emaneric/LED-heart-wearable/PCB/graphics-and-outline/main-PCB-Edge_Cuts.dxf

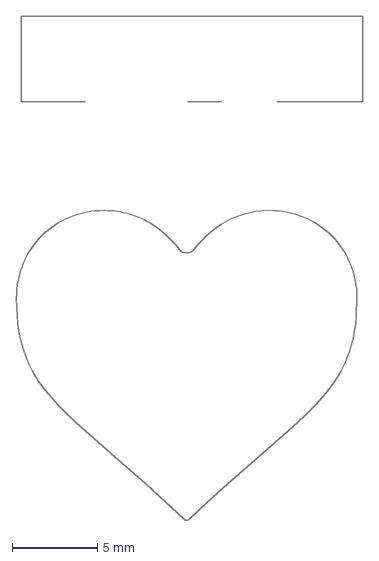
[picture p1: CAD file, 2026-05-04]
PCB/graphics-and-outline/main-PCB-Edge_Cuts.dxf
20.3 x 29.5 mm
