emaneric/LED-heart-wearable/PCB/aux-PCB/aux-PCB.step

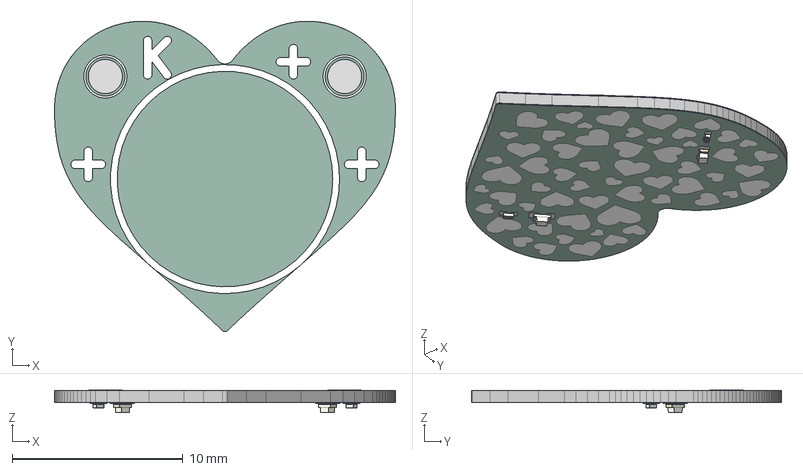
[picture p2: CAD file, 2026-03-15]
PCB/aux-PCB/aux-PCB.step
19.9 x 18.2 x 1.37 mm
R_0201_0603Metric x 2
LED_0402_1005Metric x 2
aux-PCB_pad
aux-PCB_silkscreen x 2
aux-PCB_soldermask x 2
aux-PCB_PCB
