emaneric/LED-heart-wearable/PCB/graphics-and-outline/Part Studio 1 - Sketch 1(2).dxf

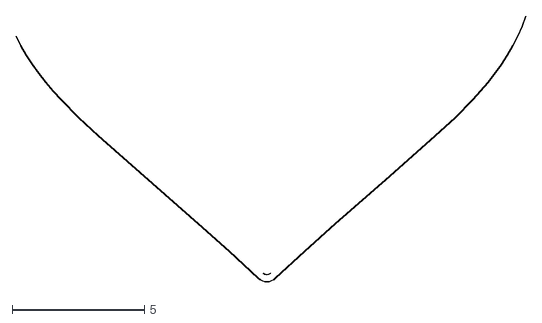
[picture p3: CAD file, 2026-05-04]
PCB/graphics-and-outline/Part Studio 1 - Sketch 1(2).dxf
19.3 x 10.1
