emaneric/LED-heart-wearable/PCB/graphics-and-outline/heart.dxf

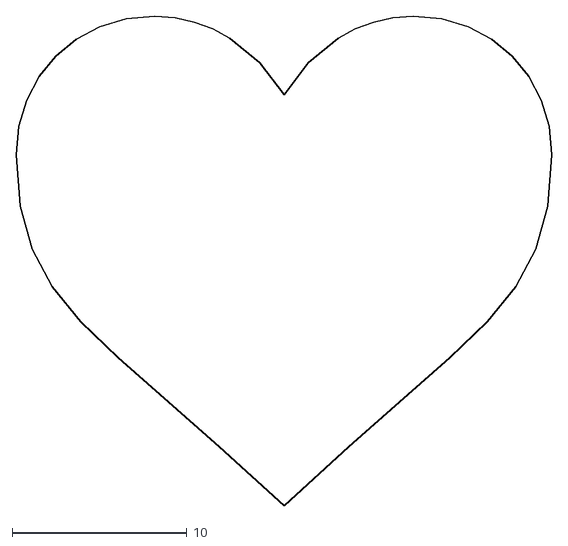
[picture p4: CAD file, 2026-03-02]
PCB/graphics-and-outline/heart.dxf
30.7 x 28.0
