emaneric/LED-heart-wearable/PCB/main-PCB/main-PCB.kicad_pcb

## KiCad design PCB/main-PCB/main-PCB.kicad_pcb (2026-08-14)

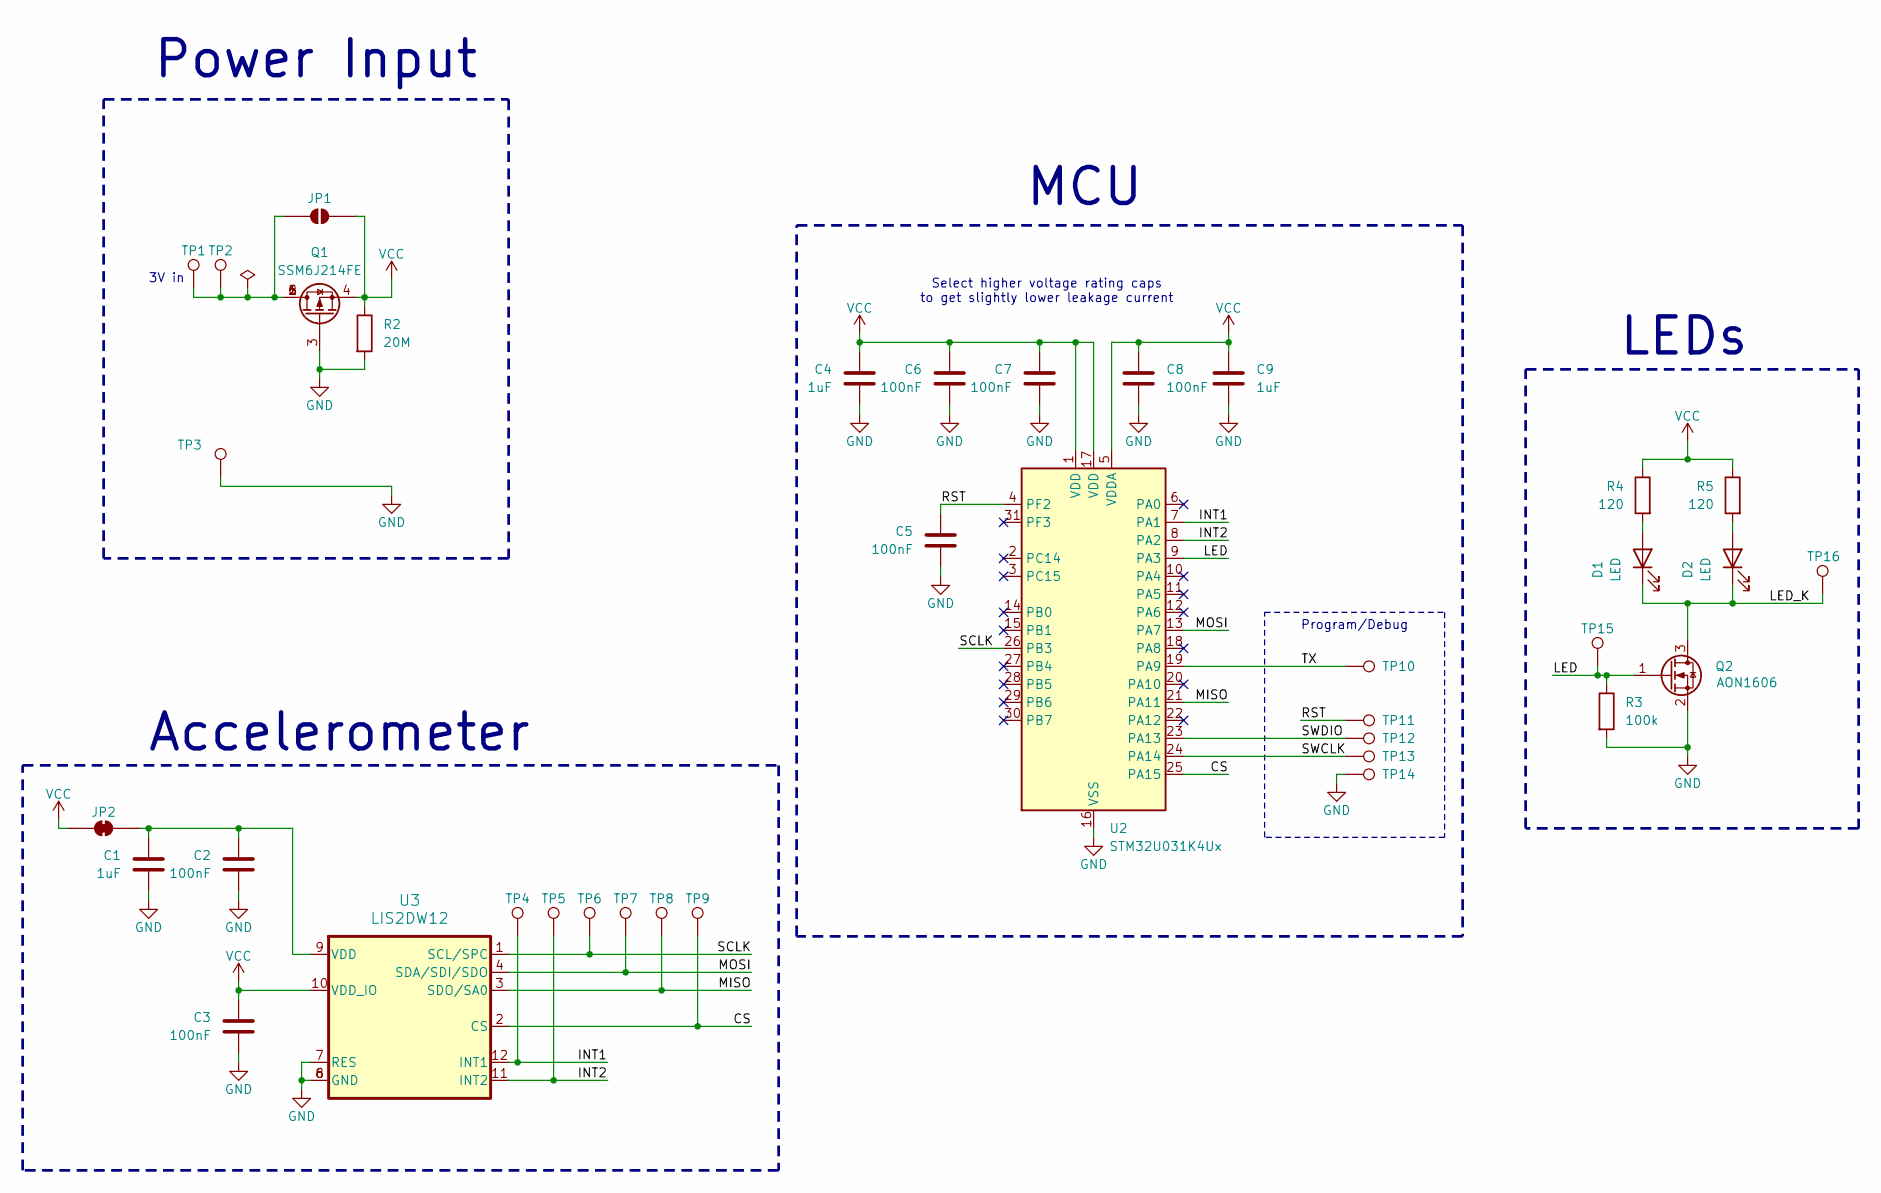
[picture p5: schematic main-PCB.kicad_sch]

Parts:
C1, C4, C9: 1uF; C_0603_1608Metric
C2, C3, C5, C6, C7, C8: 100nF; C_0402_1005Metric
D1, D2: LED; LED_0402_1005Metric
JP1: SolderJumper_2_Open; SolderJumper-2_P1.3mm_Open_RoundedPad1.0x1.5mm
JP2: SolderJumper_2_Bridged; SolderJumper-2_P1.3mm_Bridged_RoundedPad1.0x1.5mm
Q1: SSM6J214FE; SOT-563
Q2: Q_NMOS_GSD; Diodes_DFN1006-3; MPN AON1606
R2: 20M; R_0402_1005Metric
R3: 100k; R_0402_1005Metric
R4, R5: 120; R_0402_1005Metric
TP1, TP16: TestPoint; YZ00515045R-07
TP2, TP10, TP11, TP12, TP13, TP14: TestPoint; TestPoint_Pad_D1.0mm
TP3: TestPoint; YZ110715020R-01
TP4, TP5, TP6, TP7, TP8, TP9, TP15: TestPoint; TestPoint_Pad_D0.5mm
U2: STM32U031K4Ux; QFN-32-1EP_5x5mm_P0.5mm_EP3.45x3.45mm; MPN STM32U031K4U6
U3: LIS2DW12

Connections:
/CS: TP9.1 (1_1), U2.25 (PA15), U3.2 (CS)
/INT1: TP4.1 (1_1), U2.7 (PA1), U3.12 (INT1)
/INT2: TP5.1 (1_1), U2.8 (PA2), U3.11 (INT2)
/LED: Q2.1 (G), R3.1, TP15.1 (1_1), U2.9 (PA3)
/LED_K: D1.1 (K), D2.1 (K), Q2.3 (D), TP16.1 (1_1)
/MISO: TP8.1 (1_1), U2.21 (PA11), U3.3 (SDO/SA0)
/MOSI: TP7.1 (1_1), U2.13 (PA7), U3.4 (SDA/SDI/SDO)
/RST: C5.1, TP11.1 (1_1), U2.4 (PF2)
/SCLK: TP6.1 (1_1), U2.26 (PB3), U3.1 (SCL/SPC)
/SWCLK: TP13.1 (1_1), U2.24 (PA14)
/SWDIO: TP12.1 (1_1), U2.23 (PA13)
/TX: TP10.1 (1_1), U2.19 (PA9)
GND: C1.2, C2.2, C3.2, C4.2, C5.2, C6.2, C7.2, C8.2, C9.2, Q1.3 (G), Q2.2 (S), R2.2, R3.2, TP3.1 (1_1), TP14.1 (1_1), U2.16 (VSS), U2.32 (VSS), U2.33 (VSS), U3.6 (GND), U3.7 (RES), U3.8 (GND)
unnamed: D1.2 (A), R4.2
unnamed: D2.2 (A), R5.2
unnamed: JP1.1 (A), Q1.1 (D), Q1.2 (D), Q1.5 (D), Q1.6 (D), TP1.1 (1_1), TP2.1 (1_1)
unnamed: C1.1, C2.1, JP2.2 (B), U3.9 (VDD)
VCC: C3.1, C4.1, C6.1, C7.1, C8.1, C9.1, JP1.2 (B), JP2.1 (A), Q1.4 (S), R2.1, R4.1, R5.1, U2.1 (VDD), U2.5 (VDDA), U2.17 (VDD), U3.10 (VDD_IO)

Notes on the sheet:
LEDs
MCU
Power Input
Select higher voltage rating caps to get slightly lower leakage current
3V in
Accelerometer
Program/Debug

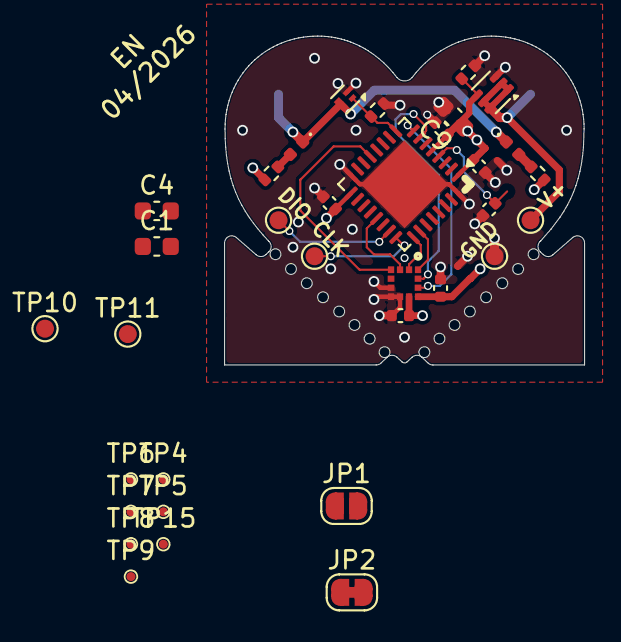
[picture p6: board main-PCB.kicad_pcb from above]

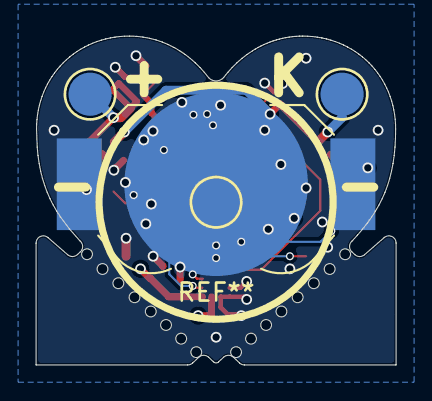
[picture p7: board main-PCB.kicad_pcb from below]

Board: 4 copper layers, 20.0 x 18.3 mm, 37 parts (3 on the bottom side), 18 nets.
