emaneric/LED-heart-wearable/PCB/aux-PCB/aux-PCB.kicad_pcb

## KiCad design PCB/aux-PCB/aux-PCB.kicad_pcb (2026-07-18)

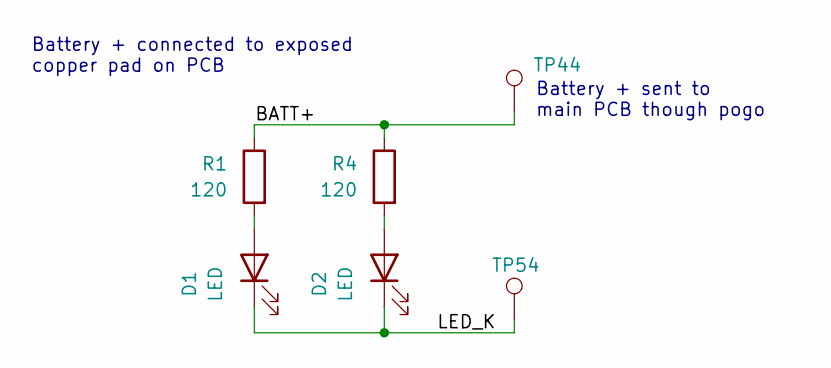
[picture p8: schematic aux-PCB.kicad_sch]

Parts:
D1, D2: LED; LED_0402_1005Metric
R1, R4: 120; R_0402_1005Metric
TP44, TP54: TestPoint; TestPoint_Pad_D2.0mm

Connections:
/BATT+: R1.1, R4.1, TP44.1 (1_1)
/LED_K: D1.1 (K), D2.1 (K), TP54.1 (1_1)
unnamed: D1.2 (A), R1.2
unnamed: D2.2 (A), R4.2

Notes on the sheet:
Battery + sent to main PCB though pogo
Battery + connected to exposed copper pad on PCB

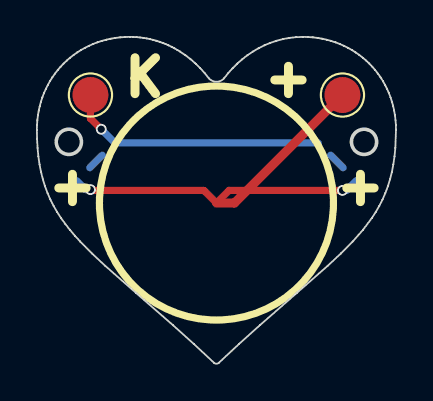
[picture p9: board aux-PCB.kicad_pcb from above]

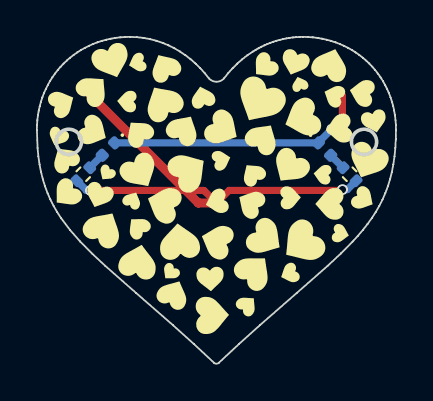
[picture p10: board aux-PCB.kicad_pcb from below]

Board: 2 copper layers, 19.9 x 18.2 mm, 6 parts (4 on the bottom side), 4 nets.
