emaneric/LED-heart-wearable/Code/LED-heart/LED-heart.ioc

Mcu.UserName=STM32U031K4Ux
PA0-CK_IN.Signal=GPIO_Analog
PA1.Signal=PWR_WKUP3
PA10.Signal=GPIO_Analog
PA15.GPIO_Label=SPI_CS
PA15.Signal=GPIO_Output
PA2.GPIO_Label=INT2
PA2.Signal=GPIO_Input
PA3.Signal=S_TIM2_CH4
PA4.Signal=GPIO_Analog
PA5.Signal=GPIO_Analog
PA6.Signal=GPIO_Analog
PA7.Signal=SPI1_MOSI
PA8.Signal=GPIO_Analog
PA9.Signal=GPIO_Analog
PB0.Signal=GPIO_Analog
PB1.Signal=GPIO_Analog
PB3.Signal=SPI1_SCK
PB4.Signal=GPIO_Analog
PB5.Signal=GPIO_Analog
PB6.Signal=GPIO_Analog
PB7.Signal=GPIO_Analog
PC14-OSC32_IN.Signal=GPIO_Analog
PC15-OSC32_OUT.Signal=GPIO_Analog
PF2-NRST.Signal=GPIO_Analog
