emaneric/LED-heart-wearable/Code/LED-heart/Core/Inc/main.h

#define INT2_Pin GPIO_PIN_2
#define INT2_GPIO_Port GPIOA
#define SPI_CS_Pin GPIO_PIN_15
#define SPI_CS_GPIO_Port GPIOA
#define INT1_Pin GPIO_PIN_1
#define INT1_GPIO_Port GPIOA
