emaneric/LED-heart-wearable/(commit log)

2026-03-04 -Added custom silkscreen -Generated gerbers -Exported STEP files
    [aux-PCB-B_Cu.gbl, aux-PCB-B_Mask.gbs, aux-PCB-B_Paste.gbp, aux-PCB-B_Silkscreen.gbo, aux-PCB-Edge_Cuts.gm1, aux-PCB-F_Cu.gtl, aux-PCB-F_Mask.gts, aux-PCB-F_Paste.gtp]
2026-03-15 -Updated STEP files
    [aux-PCB.step, main-PCB.kicad_pcb]
2026-05-04 Updated PCB STEP file
    [Part Studio 1 - Sketch 1(2).dxf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]
2026-06-07 -STarted working in accelerometer driver
2026-06-11 Initial work on LIS2DU12 driver
2026-06-23 Refactor LIS2DU12 driver: update read_FIFO function to include FIFO length and acceleration data array; modify read_register function parameter name; adjust FIFO watermark to 25 samples; enhance main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
2026-07-13 Add heartbeat LED PWM pattern and low-power sleep/wake cycle
    - Drive the heart LED via TIM2 CH4 PWM with a two-phase "lub-dub"
    ramp pattern, rest period scaled by accelerometer movement score
    - Configure LIS2DU12 wake-up-on-motion (INT2) and enter STM32
    Shutdown mode after a period of no movement
    - Set unused GPIOs to analog mode before shutdown to eliminate
    floating-pin leakage
    - Bump reverse-polarity protection gate resistor (R1) from 100k to
    2M on the PCB, cutting its static draw from 30uA to ~1.5uA
    [main-PCB.kicad_pcb, main-PCB.kicad_sch]
2026-07-18 -In progress porting code to LIS2DW12.
    [aux-PCB.kicad_pcb, main-PCB.kicad_pcb, main-PCB.kicad_sch]
2026-07-28 Changed optiisation, removed unused code, fixed bug of wrong flash size for KU4 chip
    [main-PCB.kicad_pcb, main-PCB.kicad_sch]
2026-07-28 -PCB jumper change
    [main-PCB.kicad_pcb, main-PCB.kicad_sch]
2026-08-04 Improved error handling in LIS2 sleep function. Changed pulldowns Added jumpers to PCB
    [main-PCB.kicad_pcb, main-PCB.kicad_sch]
2026-08-05 -Fixed high sleep current issuer
    [LIS2DW12.c, main.c]
2026-08-05 Updated resistor value Improved LIS init
    [main-PCB.kicad_sch]
2026-08-07 -Implemented sleep mode between LED flashes
2026-08-14 -changed accelerometer model
    [main-PCB.kicad_pcb, main-PCB.kicad_sch]
